LenShustek/microammeter/photo_in_use.jpg

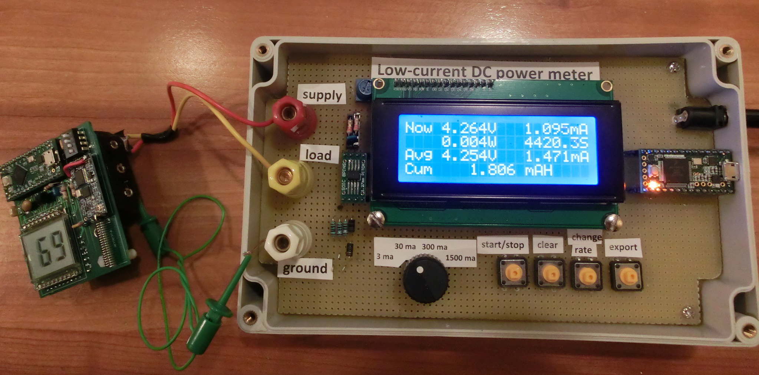
photo_in_use.jpg
