LenShustek/microammeter/microammeter_packaging.pdf

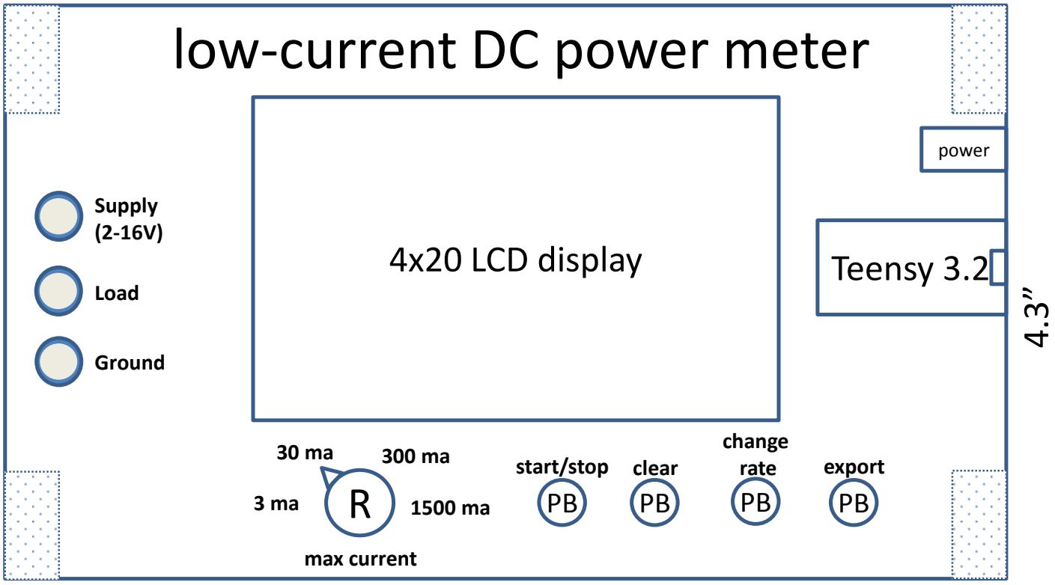
[picture p2: figure]
low-current DC power meter; 4x20 LCD display; power; max current; clear; Teensy 3.2; start/stop; export; Ground; Load; Supply (2-16V); change rate

7.5”

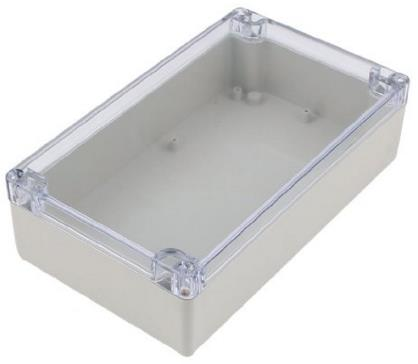
[picture p3: figure]

http://www.amazon.com/gp/product/B00XP5QUB0/8” x 4.7” x 2.2”
