LenShustek/microammeter/microammeter_design.xlsx

Sheet: display
 | 1 | 2 | 3 | 4 | 5 | 6 | 7 | 8 | 9 | 10 | 11 | 12 | 13 | 14 | 15 | 16 | 17 | 18 | 19 | 20
startup | L | o | w | - | c | u | r | r | e | n | t |  | D | C |  | m | e | t | e | r
 |  |  |  |  | V | e | r | s | i | o | n |  | 1 | . | 0
 | m | a | x |  | c | u | r | r | e | n | t | : |  | 1 | 5 | 0 | 0 | m | A
 |  |  |  |  | r | a | t | e | : |  | 2 | 0 | 0 | 0 | / | S
operation | N | o | w |  | x | . | x | x | x | V |  | x | x | x | . | x | x | x | m | A
 |  |  |  | x | x | . | x | x | x | W |  |  | t | t | t | t | t | . | t | S
 | A | v | g |  | x | . | x | x | x | V |  | x | x | x | . | x | x | x | m | A
 | C | u | m |  | x | x | x | x | . | x | x | x |  | m | A | H
stopped | W | a | s | …
 | A | v | g | …
 | C | u | m | …

Sheet: calcs
TI INA219 calculations
 |  |  |  |  |  | PGA | #bits of result | V shunt max?
 |  |  | PGA divisor (1,2,4,8) | 8 |  | 1 | 12 | 0.04096
 |  |  | V shunt max | 0.32 | V | 2 | 13 | 0.08192
 |  |  | V bus max | 16 | v | 4 | 14 | 0.16384
 |  |  | V shunt LSB | 10 | uV | 8 | 15 | 0.32768
 |  |  | V bus LSB | 4 | mV
Using the calculating engine inside the chip:
R shunt | current LSB | MaxPossible I, MaxExpected I | max power, W | min LSB | max LSB | chosen current LSB | calibration register | power LSB | max current | max current before overflow | max shunt voltage | max shunt voltage before overflow | max power
ohms | uA | mA | mW | uA | uA | uA |  | mW | mA | mA | V | V | mW
0.10 | 100.0 | 3200.0 | 1024.000 | 97.659 | 781.250 | 25.000 | 16384 | 100 | 819.18 | 819.2 | 0.0819175 | 0.0819175 | 13106.8
1.00 | 10.0 | 320.0 | 102.400 | 9.766 | 78.125 | 2.500 | 16384 | 10 | 81.92 | 81.9 | 0.0819175 | 0.0819175 | 1310.68
10.00 | 1.0 | 32.0 | 10.240 | 0.977 | 7.812 | 0.250 | 16384 | 1 | 8.19 | 8.2 | 0.0819175 | 0.0819175 | 131.068
100.00 | 0.1 | 3.2 | 1.024 | 0.098 | 0.781 | 0.025 | 16384 | 0.1 | 0.82 | 0.8 | 0.0819175 | 0.0819175 | 13.1068
Doing our own calculations based on the raw data:
R shunt | current LSB | max current | max shunt power | max load power | short-circuit shunt current | short-circuit shunt power
ohms | uA | mA | W |  | A | W
0.20 | 50.0 | 1600.0 | 0.512 | 25.6 | 80.000 | 1280
1.00 | 10.0 | 320.0 | 0.102 | 5.12 | 16.000 | 256
10.00 | 1.0 | 32.0 | 0.010 | 0.512 | 1.600 | 25.6
100.00 | 0.1 | 3.2 | 0.001 | 0.0512 | 0.160 | 2.56
 |  | samples/sec | usec/sample
 |  | 2000 | 500
 |  | 1000 | 1000
 |  | 500 | 2000
 |  | 250 | 4000
 |  | 100 | 10000
 |  | 50 | 20000
 |  | 10 | 100000
 |  | 1 | 1000000

Sheet: parts
Low-current power meter parts
1 | 2-pole 4-position rotary switch | C&K | R20407RR03Q | Digikey | CKN9482-ND | $4.67
1 | TI INA219B high-side current/power monitor | TI | INA219BIDR | Digikey | 296-27899-1-ND | $2.46
1 | 0.2 ohm 1% resistor
1 | 1.0 ohm 1% resistor
1 | 10 ohm 1% resistor
1 | 100 ohm 1% resistor
1 | power jack
1 | 4x20 LCD display kit
3 | pushbutton switch
1 | 51 ohm 1/4W resistor
1 | Teensy 3.2 microprocessor
3 | 0.1 ufd decoupling caps
1 | 10 ufd 15V tantalum filter cap
2 | 5.1K 1/8W 5% resistors
1 | custom PCB or breadboard
1 | enclosure, 8" x 4.7" x 2.2" | http://www.amazon.com/gp/product/B00XP5QUB0/

Sheet: averaging algorithm tests
See http://www.codeproject.com/Articles/807195/Precise-and-safe-calculation-method-for-the-averag
 |  |  | (An*n+v)/(n+1) |  |  |  | An + (v-An)/(n+1) |  | CMA/CMR method
vbus_mV | real avg |  |  | arduino | excel | error |  | error | cma | cmr | addendum | error
 |  | count | prev | new | new |  |  |  | 0 | 0
3164 | 3164.00 | 0 | 0 | 3164 | 3164 | 0.00 | 3164 | 0.00 | 3164 | 0 | 3164 | 0.00
3088 | 3126.00 | 1 | 3164 | 3126 | 3126 | 0.00 | 3126 | 0.00 | 3126 | 0 | -76 | 0.00
2964 | 3072.00 | 2 | 3126 | 3072 | 3072 | 0.00 | 3072 | 0.00 | 3072 | 0 | -162 | 0.00
3348 | 3141.00 | 3 | 3072 | 3141 | 3141 | 0.00 | 3141 | 0.00 | 3141 | 0 | 276 | 0.00
2964 | 3105.60 | 4 | 3141 | 3105 | 3105 | 0.60 | 3106 | -0.40 | 3106 | -2 | -177 | -0.40
3520 | 3174.67 | 5 | 3105 | 3174 | 3174 | 0.67 | 3174 | 0.67 | 3174 | 4 | 412 | 0.67
3584 | 3233.14 | 6 | 3174 | 3232 | 3232 | 1.14 | 3233 | 0.14 | 3233 | 1 | 414 | 0.14
3552 | 3273.00 | 7 | 3232 | 3272 | 3272 | 1.00 | 3272 | 1.00 | 3273 | 0 | 320 | 0.00
2820 | 3222.67 | 8 | 3272 | 3221 | 3221 | 1.67 | 3222 | 0.67 | 3223 | -3 | -453 | -0.33
2856 | 3186.00 | 9 | 3221 | 3184 | 3184 | 2.00 | 3185 | 1.00 | 3186 | 0 | -370 | 0.00
2852 | 3155.64 | 10 | 3184 | 3153 | 3153 | 2.64 | 3154 | 1.64 | 3156 | -4 | -334 | -0.36
3416 | 3177.33 | 11 | 3153 | 3174 | 3174 | 3.33 | 3175 | 2.33 | 3177 | 4 | 256 | 0.33
3364 | 3191.69 | 12 | 3174 | 3188 | 3188 | 3.69 | 3189 | 2.69 | 3191 | 9 | 191 | 0.69
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
2968 | 3202.50 | 1246 | 2913 | 2913 | 2913 | 289.50 | 2913 | 289.50 | 3203 | -629 | -629 | -0.50
2936 | 3202.28 | 1247 | 2913 | 2913 | 2913 | 289.28 | 2913 | 289.28 | 3203 | -896 | -896 | -0.72
3532 | 3202.55 | 1248 | 2913 | 2913 | 2913 | 289.55 | 2913 | 289.55 | 3203 | -567 | -567 | -0.45

Sheet: example graph
count | sec | volts | milliamps
1 | 0.004 | 4.26 | 1.192
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
