LenShustek/microammeter/graph1.pdf

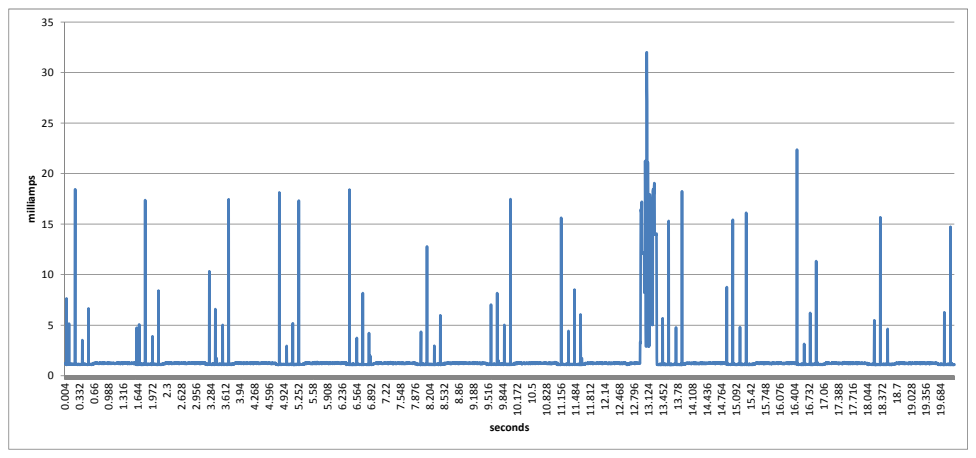
[picture p4: page 1]
milliamps; seconds
