LenShustek/microammeter/graph2.pdf

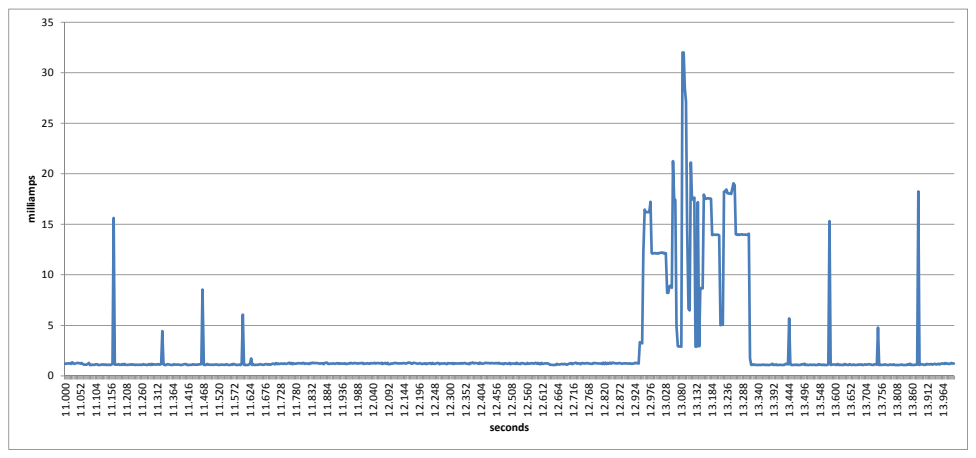
[picture p5: page 1]
milliamps; seconds
