LenShustek/microammeter/schematic.pdf

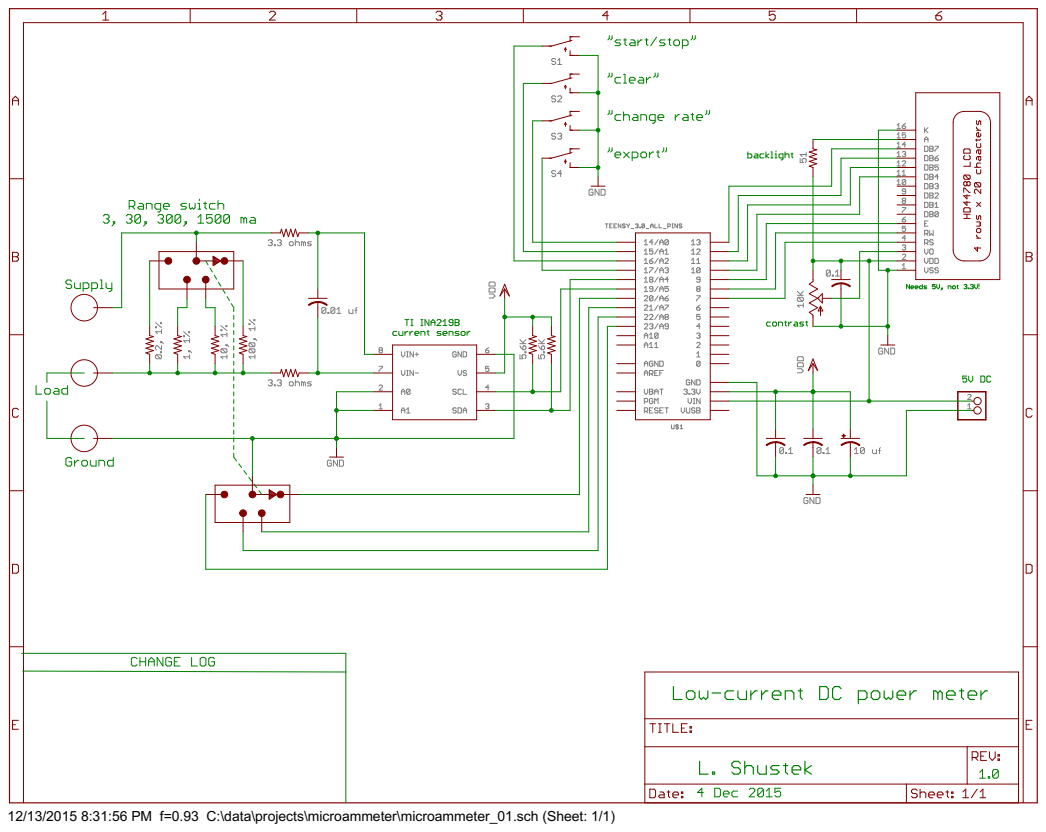
[picture p6: page 1]

12/13/2015 8:31:56 PM f=0.93 C:\data\projects\microammeter\microammeter_01.sch (Sheet: 1/1)
