LenShustek/microammeter/(commit log)

2015-12-14 Teensy/Arduino source code
2015-12-14 schematic of the box
2015-12-14 in use measuring the current of my wireless temperature sensor (see that repository)
2015-12-14 various design calculations
    [microammeter_design.xlsx]
2015-12-14 prototype board layout
2018-04-04 A couple of bug fixes to display and export formats.
    [microammeter.ino]
